TahaAmjad/SPWM-inverter/IMG_20170523_144802.jpg

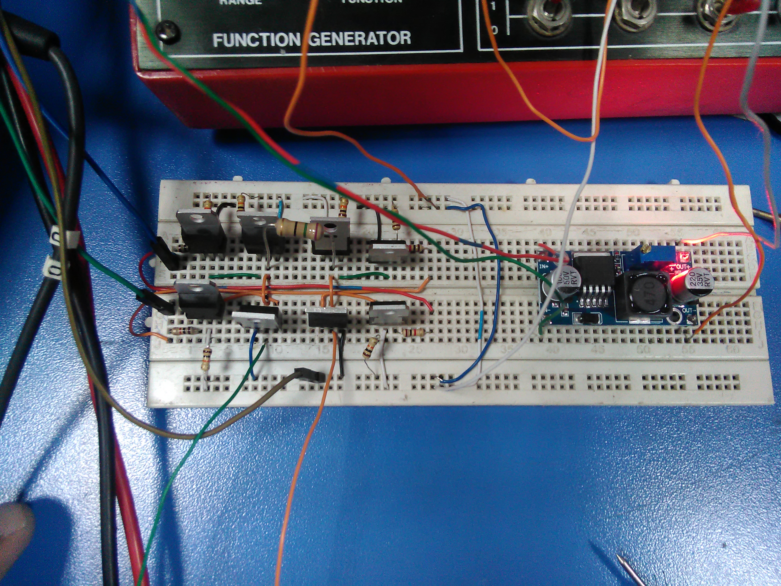
IMG_20170523_144802.jpg
