TahaAmjad/SPWM-inverter/IMG_20170523_144832.jpg

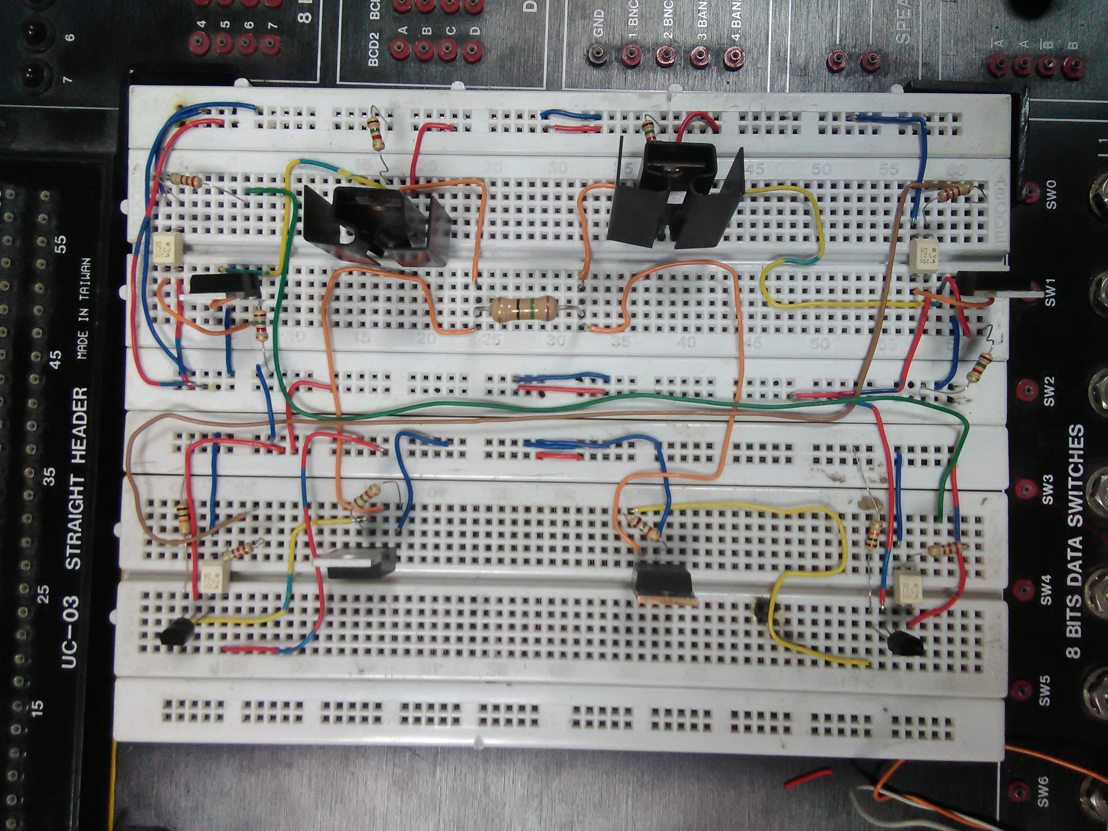
IMG_20170523_144832.jpg
