TahaAmjad/SPWM-inverter/circuit.docx

APPENDIX A (Circuit Diagrams)

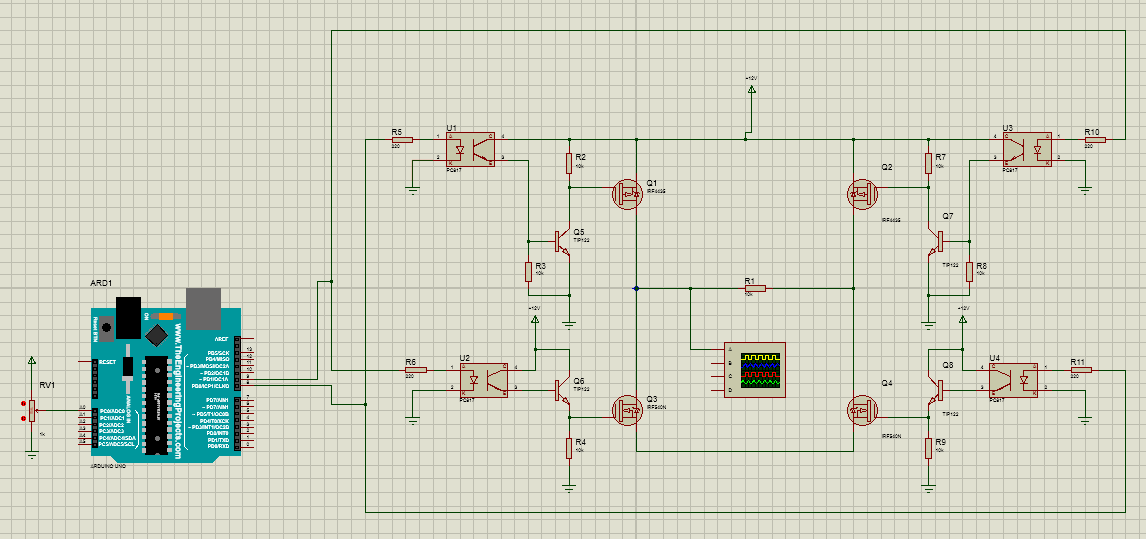
[picture p7: figure]

Fig.5: Circuit for Technique 1

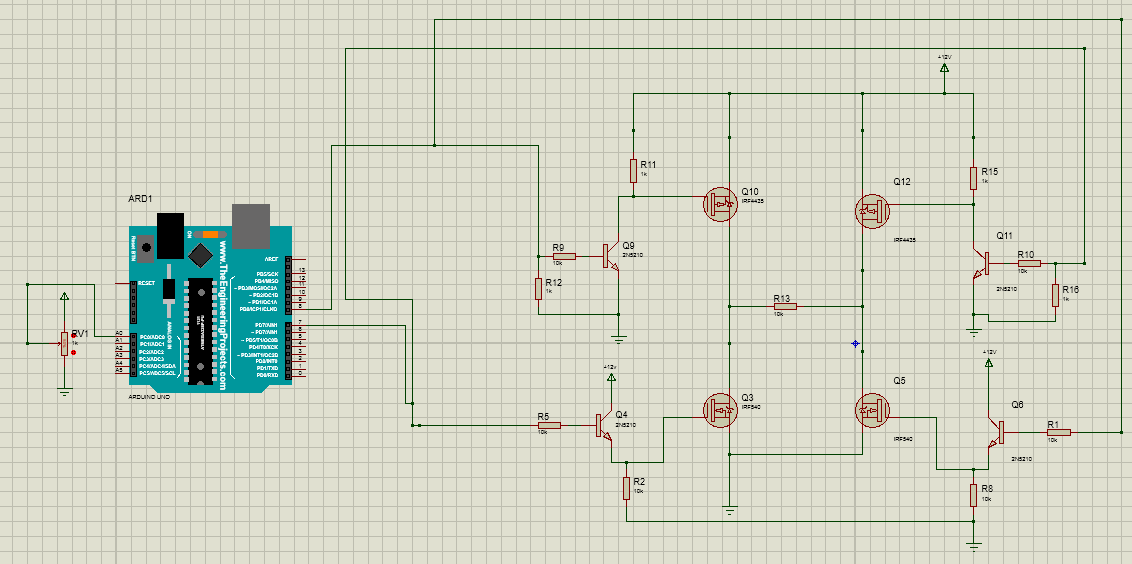
[picture p8: figure]

Fig.6: Circuit for Technique 2

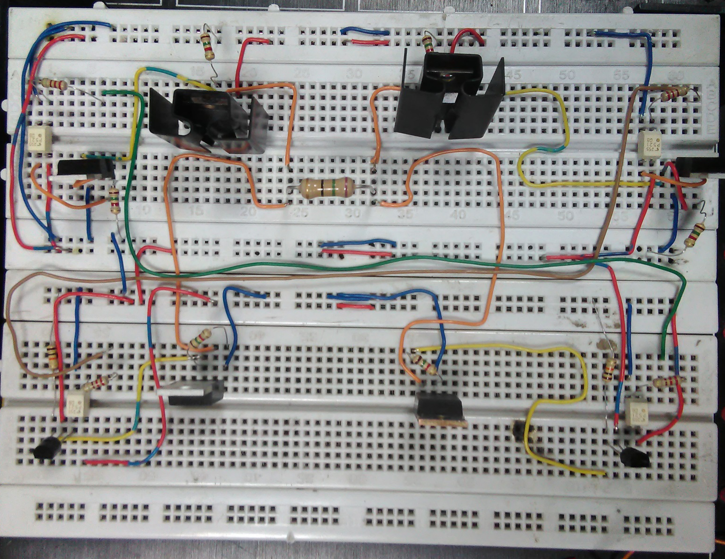
[picture p9: figure]

Fig.7: Circuit for Technique 1

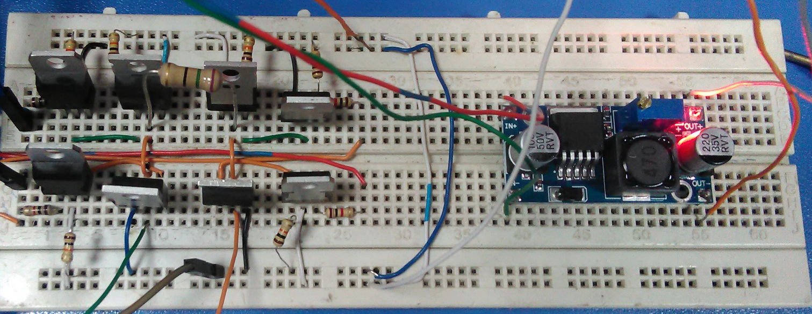
[picture p10: figure]

Fig.8: Circuit for Technique 2
