TahaAmjad/SPWM-inverter/Cover.docx

Project Report

Design and Implementation of a Fixed DC to Variable Amplitude and Frequency AC power converter

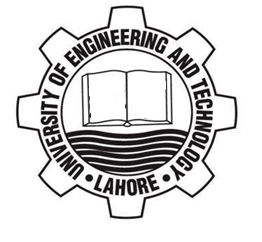
[picture p11: figure]

Submitted by:

2014-MC-01 Usman Farooq Butt

2014-MC-20 Tajammal Nawaz

2014-MC-24 Taha Amjad

2014-MC-40 Muhammad Tahir

Submitted to: Dr. M. Ahsan Naeem

Course: Power Electronics (LAB)

Submission Date: 24th May, 2017

Department of Mechatronics and Control Engineering

University of Engineering and Technology, Lahore
