TahaAmjad/SPWM-inverter/(list of files, drawings)

Other design files:
proteus schematic/final.pdsprj
